KuzeKrott/tetris_TTL/(list of files, drawings)

Other design files:
MAIN PROG!!!.ms14
